ConnectedHumber/Bus-Terminal-Signs/videos/README.md

# Some videos

Currently, I'm working with one sub-panel, so it's only 72 LEDs wide
