ConnectedHumber/Bus-Terminal-Signs/Interfacing/README.md

# Interfacing

The panels have an 8 way IDC cable which normally connects to the interface PCB. This can be connected to an Arduino by removing the IDC connector and soldering it to a female header.

I used the ESP32 DEV KITC V1 to drive the panels.
