ConnectedHumber/Bus-Terminal-Signs/pics/First LED panel pcb top.jpg

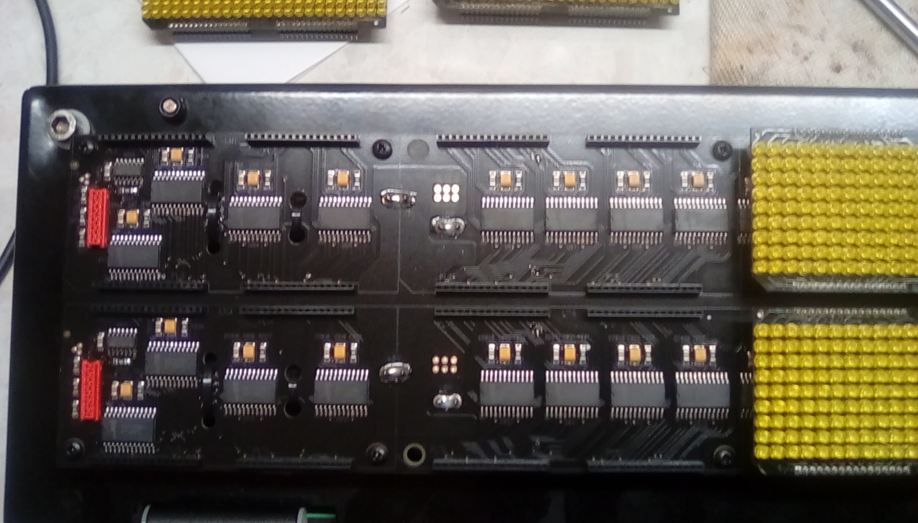
pics/First LED panel pcb top.jpg
