ConnectedHumber/Bus-Terminal-Signs/pics/Led Panel Input End.jpg

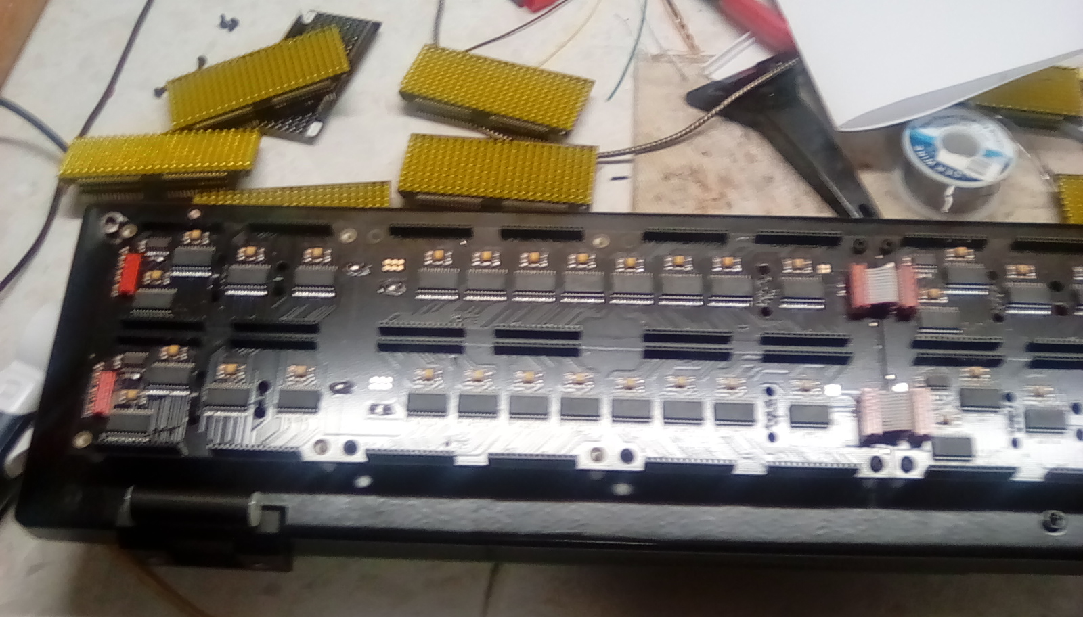
pics/Led Panel Input End.jpg
