ConnectedHumber/Bus-Terminal-Signs/pics/Ribbon Cable.jpg

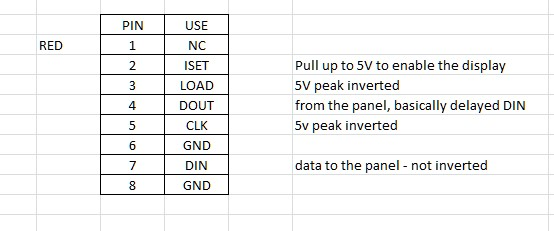
pics/Ribbon Cable.jpg
