ConnectedHumber/Bus-Terminal-Signs/images/setup_dmx-pcb.png

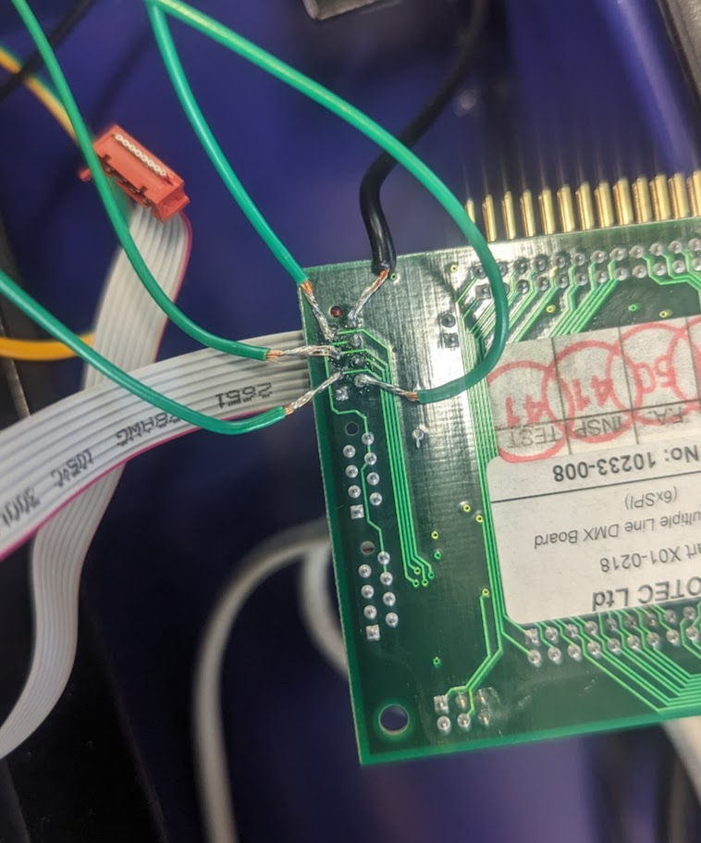
images/setup_dmx-pcb.png
