ConnectedHumber/Bus-Terminal-Signs/(threads)

Thread 4 (2023-08-16):

Add SPI support

alifeee, 2023-08-16:
This is something I was working on (see [branch on the fork](https://github.com/alifeee/Bus-Terminal-Signs/tree/add-SPI)) but didn't get to finish. I will remain work on it soon. I place this issue here to remember to do so.

It speeds up the communication by 10 or 50 times, using Arduino's SPI library, as the clock pulse width can be as low as 10 ns (bit banging is 1 us).

BNNorman, 2023-08-17:
Great improvements, thank you.

I planned to switch to SPI when I first created this repo but never got around to it.

BNNorman, 2023-09-05:
We (connected humber) are meeting at the Makerspace tomorrow from 5:30 tomorrow. It would be good to shake hands.

alifeee, 2023-09-05:
> We (connected humber) are meeting at the Makerspace tomorrow from 5:30 tomorrow. It would be good to shake hands.

I will be there :)
