ConnectedHumber/Bus-Terminal-Signs/Interfacing/Interface Using a Level Shifter.pdf

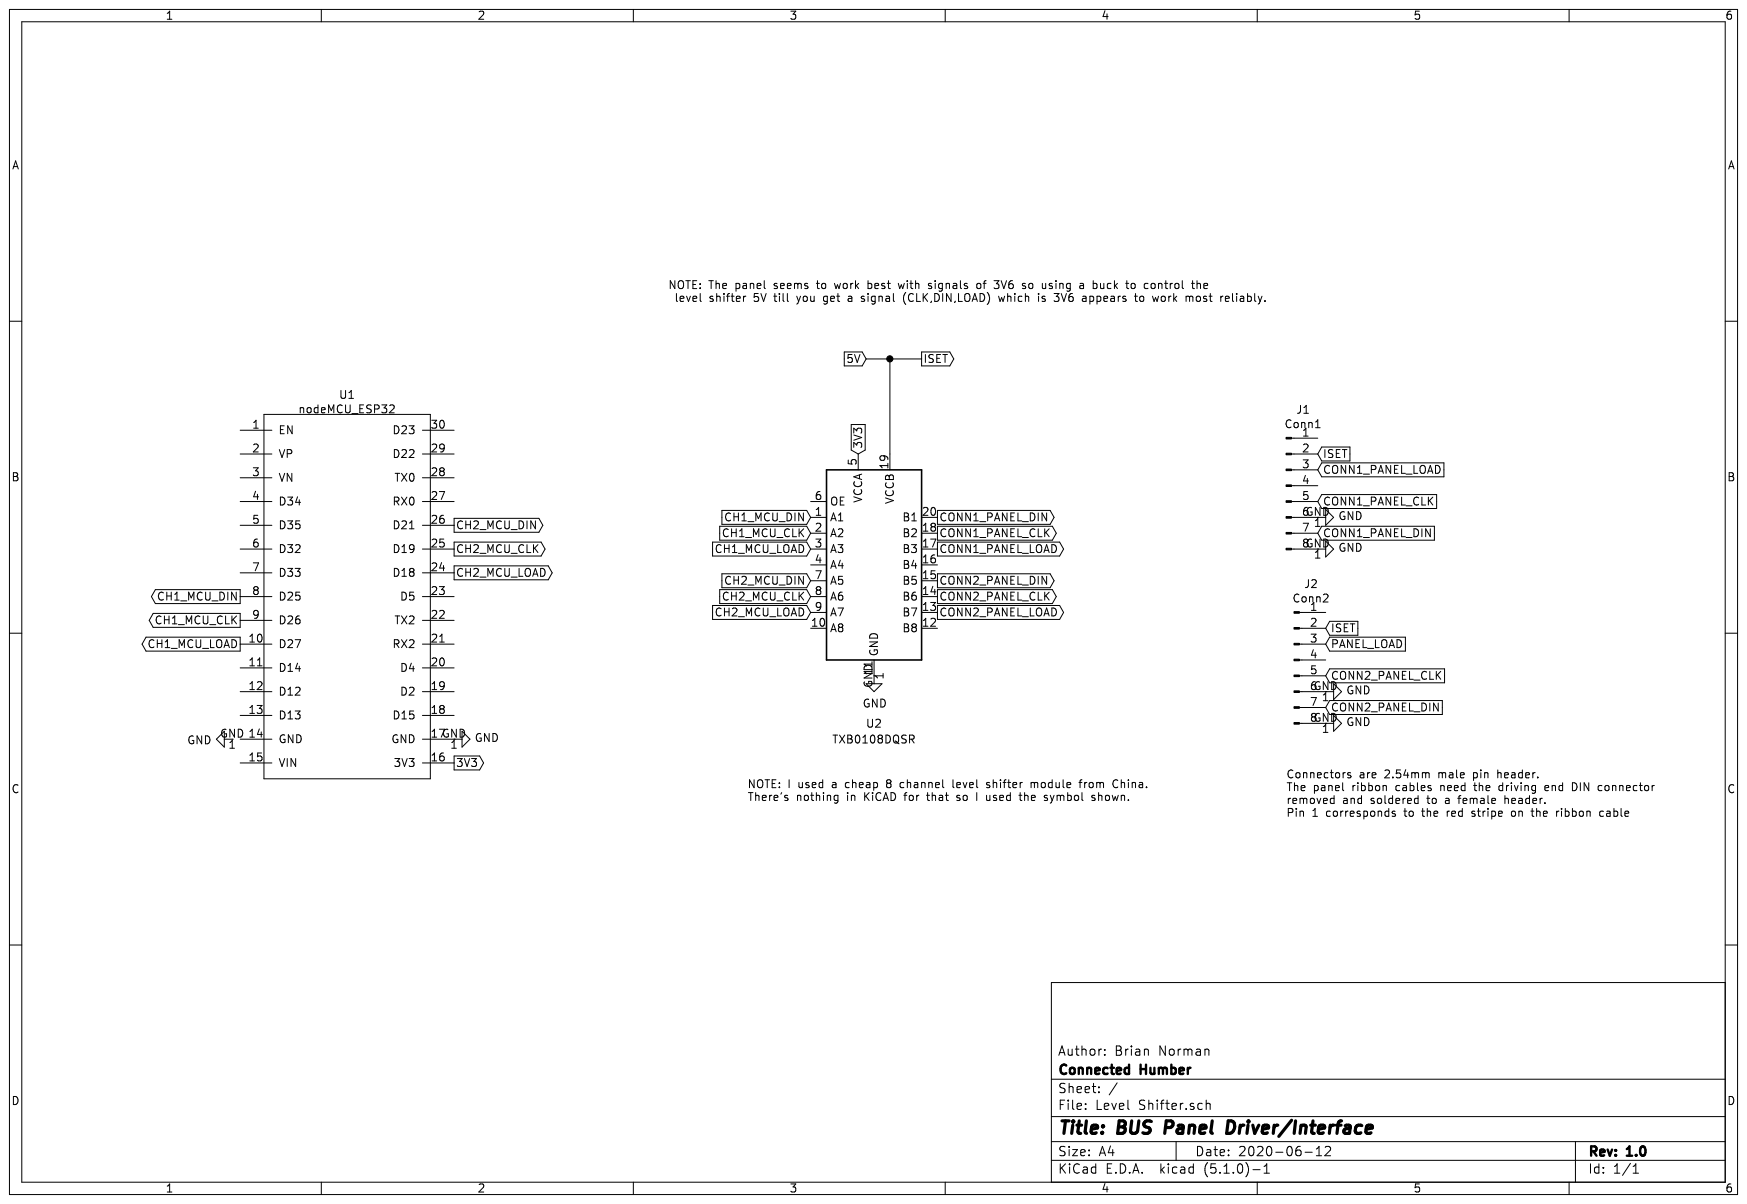
[picture p15: page 1]
