ConnectedHumber/Bus-Terminal-Signs/(commit log)

2020-06-11 added code to setPixel/getPixel to ignore out of bounds coordinates which cause a meditation exception on my ESP32.
    If the coordinates are out of boiunds setPixel() does nothing whilst getPixel() returns zero. (LED off)
2020-06-12 Scrolling text implemented on upper and lower led rows
2020-06-12 Scrolls text on both rows of the LED panel
2023-08-12 replace bit banging with SPI
    [CH_AS1100.cpp]
2023-08-16 add SPI.md
2023-09-03 fix link to class doxygen went from snake case to camelcase I do not know why
    [CH_AS1100.cpp]
2023-09-04 add SPI (not working)
    [CH_AS1100.cpp]
2023-09-05 Add SPI support remove data and clk pins these are always 11 (data) and 13 (clk) ...for SPI communication also remove INVERTED and USE_SPI defs and remove clk() function (no longer needed without bit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
    and include
    [CH_AS1100.cpp, CH_AS1100.h]
2023-09-05 fix scroll rows (bottom row didn't scroll)
    [CH_AS1100.cpp]
2023-09-06 expand on pin connections in text
